DavidMead182/PiFridge/README.md

# PiFridge — Real-Time Smart Fridge Inventory & Vitals Monitor


pifridge_logo

PiFridge is a Raspberry Pi 5-powered real-time embedded system that scans food via barcodes or object detection and monitors fridge environmental conditions. This is to keep an accurate view of the contents of your fridge

Built as a real-time embedded systems project at the University of Glasgow.

## Demos

### Release 1.0.0
https://github.com/user-attachments/assets/53e45bcc-b019-4719-8e95-a27df21b1405

### Webapp view

| Desktop | Mobile Phone |
|---|---|
|  | pifridge_iphone_notch |

### 3D Model
[Link to Fusion Files](3D_Model)

| Component Layout | Case & Lid |
|---|---|
|  |  |

## Table of Contents
- [Bill of Materials](#bill-of-materials)
- [Circuit Setup](#circuit-setup)
- [Installation](#installation--clone-to-running-program)
- [Documentation](#documentation---update-as-we-go)
- [Latency Timings](#latency-timings)
- [Social Media](#social-media)
- [Acknowledgements](#acknowledgements)
- [Authors & Contributions](#authors--contributions)
- [Future Work](#future-work)
- [License](#license)

## Bill of Materials

**Total Amount: £119.36**

During this project only £42.17 was spent as raspberry pi, pi camera and breadboard & wires were provided thanks to Glasgow Uni

### Controller

| Microcontroller | Quantity | Cost (£) | Link |
|---|---|---|---|
| Raspberry Pi 5 | 1 | 43.20 | [LINK](https://thepihut.com/products/raspberry-pi-5) |

### Sensors

| Component | Quantity | Cost (£) | Link |
|---|---|---|---|
| Raspberry Pi Camera Module 3 | 1 | 24 | [LINK](https://thepihut.com/products/raspberry-pi-camera-module-3?src=raspberrypi) |
| BME680 – Temperature/Humidity/Gas Sensor | 1 | 8.71  | [LINK](https://shop.watterott.com/BME680-Breakout-Qwiic-Luftfeuchtigkeits-Druck-Temperatur-Luftguetesensor) |
| BH1750 – Ambient Light Sensor | 1 | 3.62 | [LINK](https://cpc.farnell.com/dfrobot/sen0097/fermion-bh1750-light-sensor-breakout/dp/SC21071) |
| Barcode Scanner | 1 | 29.84  | [LINK](https://www.waveshare.com/barcode-scanner-module.htm) |

### Miscellaneous

| Component | Quantity | Cost (£) | Link |
|---|---|---|---|
| Wires & breadboard |  1 | 9.99 | [LINK](https://www.amazon.co.uk/Breadboard-tie-Points-Flexible-U-Shape-JumperWires/dp/B0BMFXPSVG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) |

## Circuit Setup
### Diagram


### Real Life Setup
WhatsApp Image 2026-04-12 at 21 28 18

## Installation — Clone to Running Program
### 1. Clone the repo
 
```bash
git clone https://github.com/DavidMead182/PiFridge.git
cd PiFridge
```
 
### 2. Install dependencies
 
```bash
sudo apt update
sudo apt install -y nginx libfcgi-dev cmake pkg-config libcurl4-openssl-dev build-essential libtensorflow-lite-dev libopencv-dev libsqlite3-dev
```

### 2.1 Configuration of Serial and I2C Interfaces

In order to get this program to run, you need to enable certain interfaces on your Raspberry Pi:

1. Run `sudo raspi-config` and follow these steps:

   - Go to **Interface Options** > **Serial Port**:
     - "Would you like the login shell to be accessible over serial?" **No**
     - "Would you like the serial port hardware to be enabled?" **Yes**
   
   - Go to **Interface Options** > **I2C**:
     - "Would you like the ARM I2C interface to be enabled?" **Yes**
   
2. Finish and reboot when prompted or run `sudo reboot` manually.

### Hardware Peripherals Configuration

Make sure your peripherals are connected and running on the following interfaces:

- **Light sensor**: I2C address `0x23`
- **Heat sensor**: I2C address `0x76`
- **Barcode sensor**: `/dev/ttyAMA0`

Ensure that these devices are connected properly to avoid any hardware-related issues.

### 3. Build & Run

#### Option A — Running Without Website

If you prefer not to run the website, you can build and run the program without it. Follow these steps:

**1. Build from the repo root**:

```bash
cmake -B build && cmake --build build
```

**2. Run the program**
   
```bash
sudo ./build/src/pifridge
```

#### Option B — Using `run.sh` (Recommended)
 
`run.sh` handles building, permissions, socket setup, and starting all processes in the correct order.
 
> **Note:** Open `run.sh` and set `PI_USER` at the top to your Raspberry Pi username if it differs from `pifridge`.
 
```bash
chmod +x run.sh
./run.sh
```
 
Once running, the terminal will print the URL to open in your browser:
 
```
===========================================
  PiFridge is running!
  Open in your browser:
    On this Pi:          http://localhost
    From another device: http://<Pi's IP>
===========================================
```
 
Stop all processes with `Ctrl+C`.
 
> **Note:** Tests covering direct GPIO writes and hardware-dependent classes are run separately via test executables in each subdirectory, as they require physical hardware to be connected.
 
---
 
#### Option C — Manual Steps
 
If you prefer to run each step yourself, follow the sequence below. Replace `pifridge` with your Raspberry Pi username throughout.
 
**1. Build**
 
```bash
cmake -B build .
cmake --build build
```
 
**2. Copy web app files to nginx serve directory**
 
```bash
sudo mkdir -p /var/www/pifridge
sudo cp src/web_app/index.html /var/www/pifridge/
sudo chown -R www-data:www-data /var/www/pifridge
```
 
**3. Create socket directory with correct permissions**
 
```bash
sudo mkdir -p /var/run/pifridge
sudo chown pifridge:www-data /var/run/pifridge
sudo chmod 770 /var/run/pifridge
```
 
**4. Create database directory**
 
```bash
sudo mkdir -p /var/lib/pifridge
sudo chown pifridge:pifridge /var/lib/pifridge
```
 
**5. Start nginx**
 
```bash
sudo systemctl start nginx
```
 
**6. Kill any existing PiFridge processes (if restarting)**
 
```bash
pkill -x pifridge_api       2>/dev/null || true
pkill -x pifridge_inventory 2>/dev/null || true
sleep 0.5
```
 
**7. Start the vitals FastCGI API**
 
```bash
./build/src/web_app/pifridge_api &
```
 
Then fix socket permissions:
 
```bash
sleep 1
sudo chown pifridge:www-data /var/run/pifridge/pifridge.sock
sudo chmod 660 /var/run/pifridge/pifridge.sock
```
 
**8. Start the inventory FastCGI API**
 
```bash
./build/src/web_app/pifridge_inventory &
```
 
Then fix socket permissions:
 
```bash
sleep 1
sudo chown pifridge:www-data /var/run/pifridge/pifridge_inventory.sock
sudo chmod 660 /var/run/pifridge/pifridge_inventory.sock
```
 
**9. Start the main sensor process**
 
```bash
sudo ./build/src/pifridge
```
 
### 4. Open Website
 
**On the Raspberry Pi:**
 
```
http://localhost
```
 
**From another device on the same WiFi:**
 
```
http://<IP address of Raspberry Pi>
```
 
To find the Pi's IP address:
 
```bash
hostname -I
```

## Documentation - update as we go

- [BH1750 Light Sensor](src/BH1750/README.md)
- [BME680 Temp, Humidity and Pressure Sensor](src/BME680/README.md)
- [Barcode Sensor](src/BarcodeScanner/README.md)
- [Raspberry Pi Camera](src/Camera/README.md)
- [NGINX Config](config/README.md)
- [Web App](src/web_app/README.md)
- [Common Includes](src/common/README.md)
- [Main Program](src/README.md)

## Latency Timings

| Sensor | Operation | Mean Time |
|---|---|---|
| BH1750 | Light change → console | 341μs |
| BH1750 | Light change → webapp | 638ms |
| BME680 | Data change → console | 184ms |
| BME680 | Data change → webapp | 822ms |
| Barcode Scanner | Scan → product name on console | 1154ms |
| Barcode Scanner | Scan → product on webapp | 2248ms |
| Pi Camera | Object detected → console | 832ms |
| Pi Camera | Object detected → webapp | 1926ms |

> **Note:** Each sensor was timed from data change to output appearing on both the console and webapp, with each measurement repeated 3 times. Full timing logs are available in the respective sensor readmes linked above.

## Social Media
 
| Platform | Handle / Link |
|---|---|
| Instagram  | [@pi_fridge](https://www.instagram.com/pi_fridge) |

## Acknowledgements

We would like to thank **Dr. Bernd Porr** for supervising this project and for providing the foundational teaching material that underpins the real-time architecture of PiFridge. His course notes, [*Realtime Embedded Coding in C++ under Linux*](https://berndporr.github.io/realtime_cpp_coding/), were an essential reference throughout development — covering event-driven design, callback-based programming, threading, and GPIO interfacing on the Raspberry Pi under Linux.
 
We would also like to thank **Dr. Chongfeng Wei** for his lectures on software engineering, which informed how we structured, tested, and managed the codebase across the team.
 
Finally, we extend our thanks to the technicians for their support with hardware and resources.

## Authors & Contributions
 
| Name | Contributions |
|---|---|
| David Mead | BME680 sensor class, Nginx & Webapp Startup & Integration with Main Program, Main Program Integration, cmakelists, bash run script, documentaton, and 3D model design |
| Hamna Khalid | BH1750 light sensor module, Code Refactoring, door state controller logic, CMake test restoration, Raspberry Pi hardware validation of the BH1750 sensor path and combined BH1750/BME680 sensor setup in the lab, and BH1750 module documentation  |
| Patrick Dawodu | Webapp design, Nginx configuration, and 3D Model Design |
| Ross Cameron | Barcode sensor class, Main Program Integration, Code Refactoring, Callback changes for Camera, Latency measurements, cmakelists, 3D model design, product assembly, and Inventory UI Improvements |
| Ryan Ho | Object & Text Detection Classes, Main Program Integration, Documentation and 3D Model Design, cmakelists, and Inventory UI Improvements |

## Future Work

- Creating notifications for when items will go out of date or when the fridge is not at the required temperature.
- Creating an app for the device.
- Making the camera detect the Best Before Date more accurately.

## License

### cppTimer
The Timer Wrapper C++ class was adopted from [Bernd Porr](https://github.com/berndporr/cppTimer).
 
*Last updated: 20/04/2026*
