DavidMead182/PiFridge/(list of files, cad)

Other CAD files:
3D_Model/Lid and Case.f3z
