DavidMead182/PiFridge/(commit log)

2026-02-12 C++ test for the raspberryPI
2026-02-12 Proof of concept worked on raspberry pi, but could not push for some reason, changes made here, Closes #8, Closes #9
2026-02-12 Camera funcitonal and exploring object detection, closes #7
2026-02-24 Created BME280 sensor header
2026-02-24 created it for a sliglthly differnt sensor, the BME680 is what we have not the 280
2026-02-25 feat: add BH1750 I2C light sensor implementation
2026-02-25 build: separate logic tests from optional Raspberry Pi hardware build
2026-02-25 feat: store last lux reading for diagnostics and calibration
2026-02-25 feat: add event driven demo loop using epoll timerfd and signalfd
2026-02-25 docs: add rpi_sensors readme for wiring build and calibration
2026-02-25 feat: make light sensor demo multithreaded with eventfd worker
2026-02-25 docs: add tracking note for light sensor issue
    Closes #6
2026-03-12 Update sensor name to BME680 in README
2026-03-12 Add images to Circuit Setup section
    Added images to the Circuit Setup section in README.
2026-03-21 BME680 fixed for callbacks
    [BME680.cpp, BME680.hpp, II2CDevice.hpp, LinuxI2CDevice.cpp, LinuxI2CDevice.hpp]
2026-03-23 Delete .github/workflows directory
    getting rid of this for now. Currently running one test that fails every time
2026-03-24 Adding in a BME680 sensor class that uses the BME80 header file functions, and starting on the main.cpp (implemnting BME680)
2026-03-24 Started main program, added in BME senor stuff, tried to make it callback, will start to integrate the door sensor now
2026-03-24 Tried to implement the light sensor in, needs to be simplified, very hard to understand waht is going on, testing in the lab tomorrow
2026-03-26 Fix hardware naming, sensor address 0x76, and add Python API
    [BME680.hpp, BME680Sensor.cpp, LinuxI2CDevice.hpp, main.cpp]
2026-03-30 Reverting last commit because it included unnecessary files and unsure what it does
    [BME680Sensor.cpp]
2026-04-01 simplified light sensor code, also removed gpio output as we don't need an output pin to control anything
2026-04-10 add camera module with TFLite object detection and OCR, build successful
2026-04-11 camera fix: switch to rpicam and correct filepaths, successful runtime camera capture
    [main.cpp]
2026-04-11 camera fix:increased confidence threshold to 0.7 and added --zsl to capture command
    [main.cpp]
2026-04-11 camera fix: filter object detection results to only food, fix TFLite label indexing issues
2026-04-11 camera refactor: suppressed rpicam output and reduce unnecessary logs
2026-04-11 camera fix: switched OCR to --psm 11 for better sparse text detection and added whitelist characters
    [main.cpp]
2026-04-11 camera improvement: extract expiry date candidates
2026-04-11 potential barcode scanner fix
    [main.cpp]
2026-04-11 pot fix for barcode scanner no staying on
    [main.cpp]
2026-04-12 Adding in fixes for increment button for web site
2026-04-12 First iteration of camera integration
2026-04-12 Revise README with updated project details
    Updated the README to include detailed Bill of Materials, Circuit Setup, Acknowledgements, and Authors sections. Removed outdated sections and added links for components.
2026-04-12 Update quantity for wires and breadboard in README
2026-04-12 Documentation for BME sensor, need to add test, so i will create new branch once i have completed the documentation for my stuff
2026-04-13 Insert logo in README
    Added logo to README for visual enhancement.
2026-04-13 Revise README for common I2C abstraction layer
    Updated README.md to reflect changes in the common module's I2C abstraction layer, including details on usage, error handling, and dependencies.
2026-04-13 Added Camera README.md
2026-04-13 Added comments Camera.cpp, Camera.hpp, and camera relevant parts of main.cpp
2026-04-13 add sleep before starting the scanner to prevent scanning multiple items
    [main.cpp]
2026-04-14 Update README with website access instructions
    Added instructions for accessing the website on Raspberry Pi and other devices.
2026-04-14 Adding in 3D models
    [Case.f3d, LID.f3d]
2026-04-15 adding in new lid model, and updating readme pictures of it
    [LID.f3d]
2026-04-16 lower delay on camera as delay with processing already substantial
2026-04-16 latency timings and contributions in README
    Updated latency timings for various sensors and added detailed notes on measurement methods. Expanded contributions section to include latency measurements by Ross Cameron.
2026-04-17 fix issue of camera not shutdown gracefully
2026-04-20 Add section explaining how to configure hardware for the raspberry pi
